bigdisp/scoreboard-hardware/case/case_uC_segment_control_lid.stl

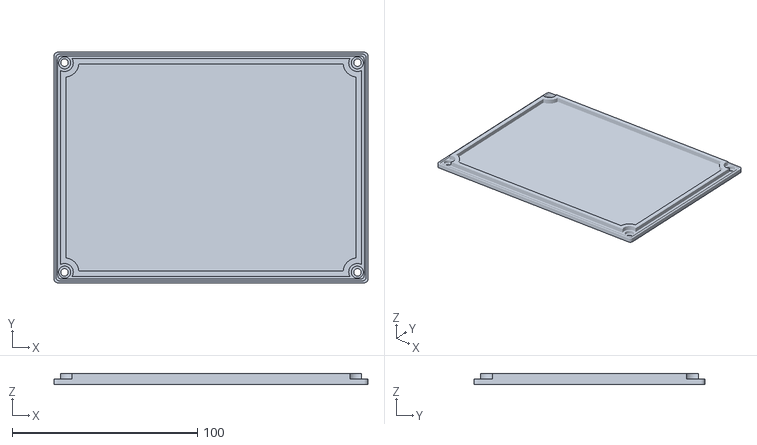
[picture p1: CAD file, 2016-05-19]
case/case_uC_segment_control_lid.stl
169.4 x 124.4 x 6.00
