bigdisp/scoreboard-hardware/case/case_uC_segment_control_box.stl

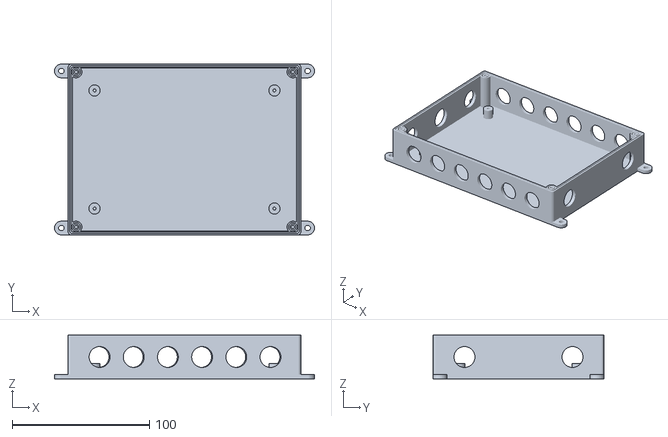
[picture p2: CAD file, 2016-05-19]
case/case_uC_segment_control_box.stl
189.4 x 124.4 x 31.7
