bigdisp/scoreboard-hardware/board_schematic/uC_segment_control.kicad_pcb

## KiCad design board_schematic/uC_segment_control.kicad_pcb (2016-05-19)

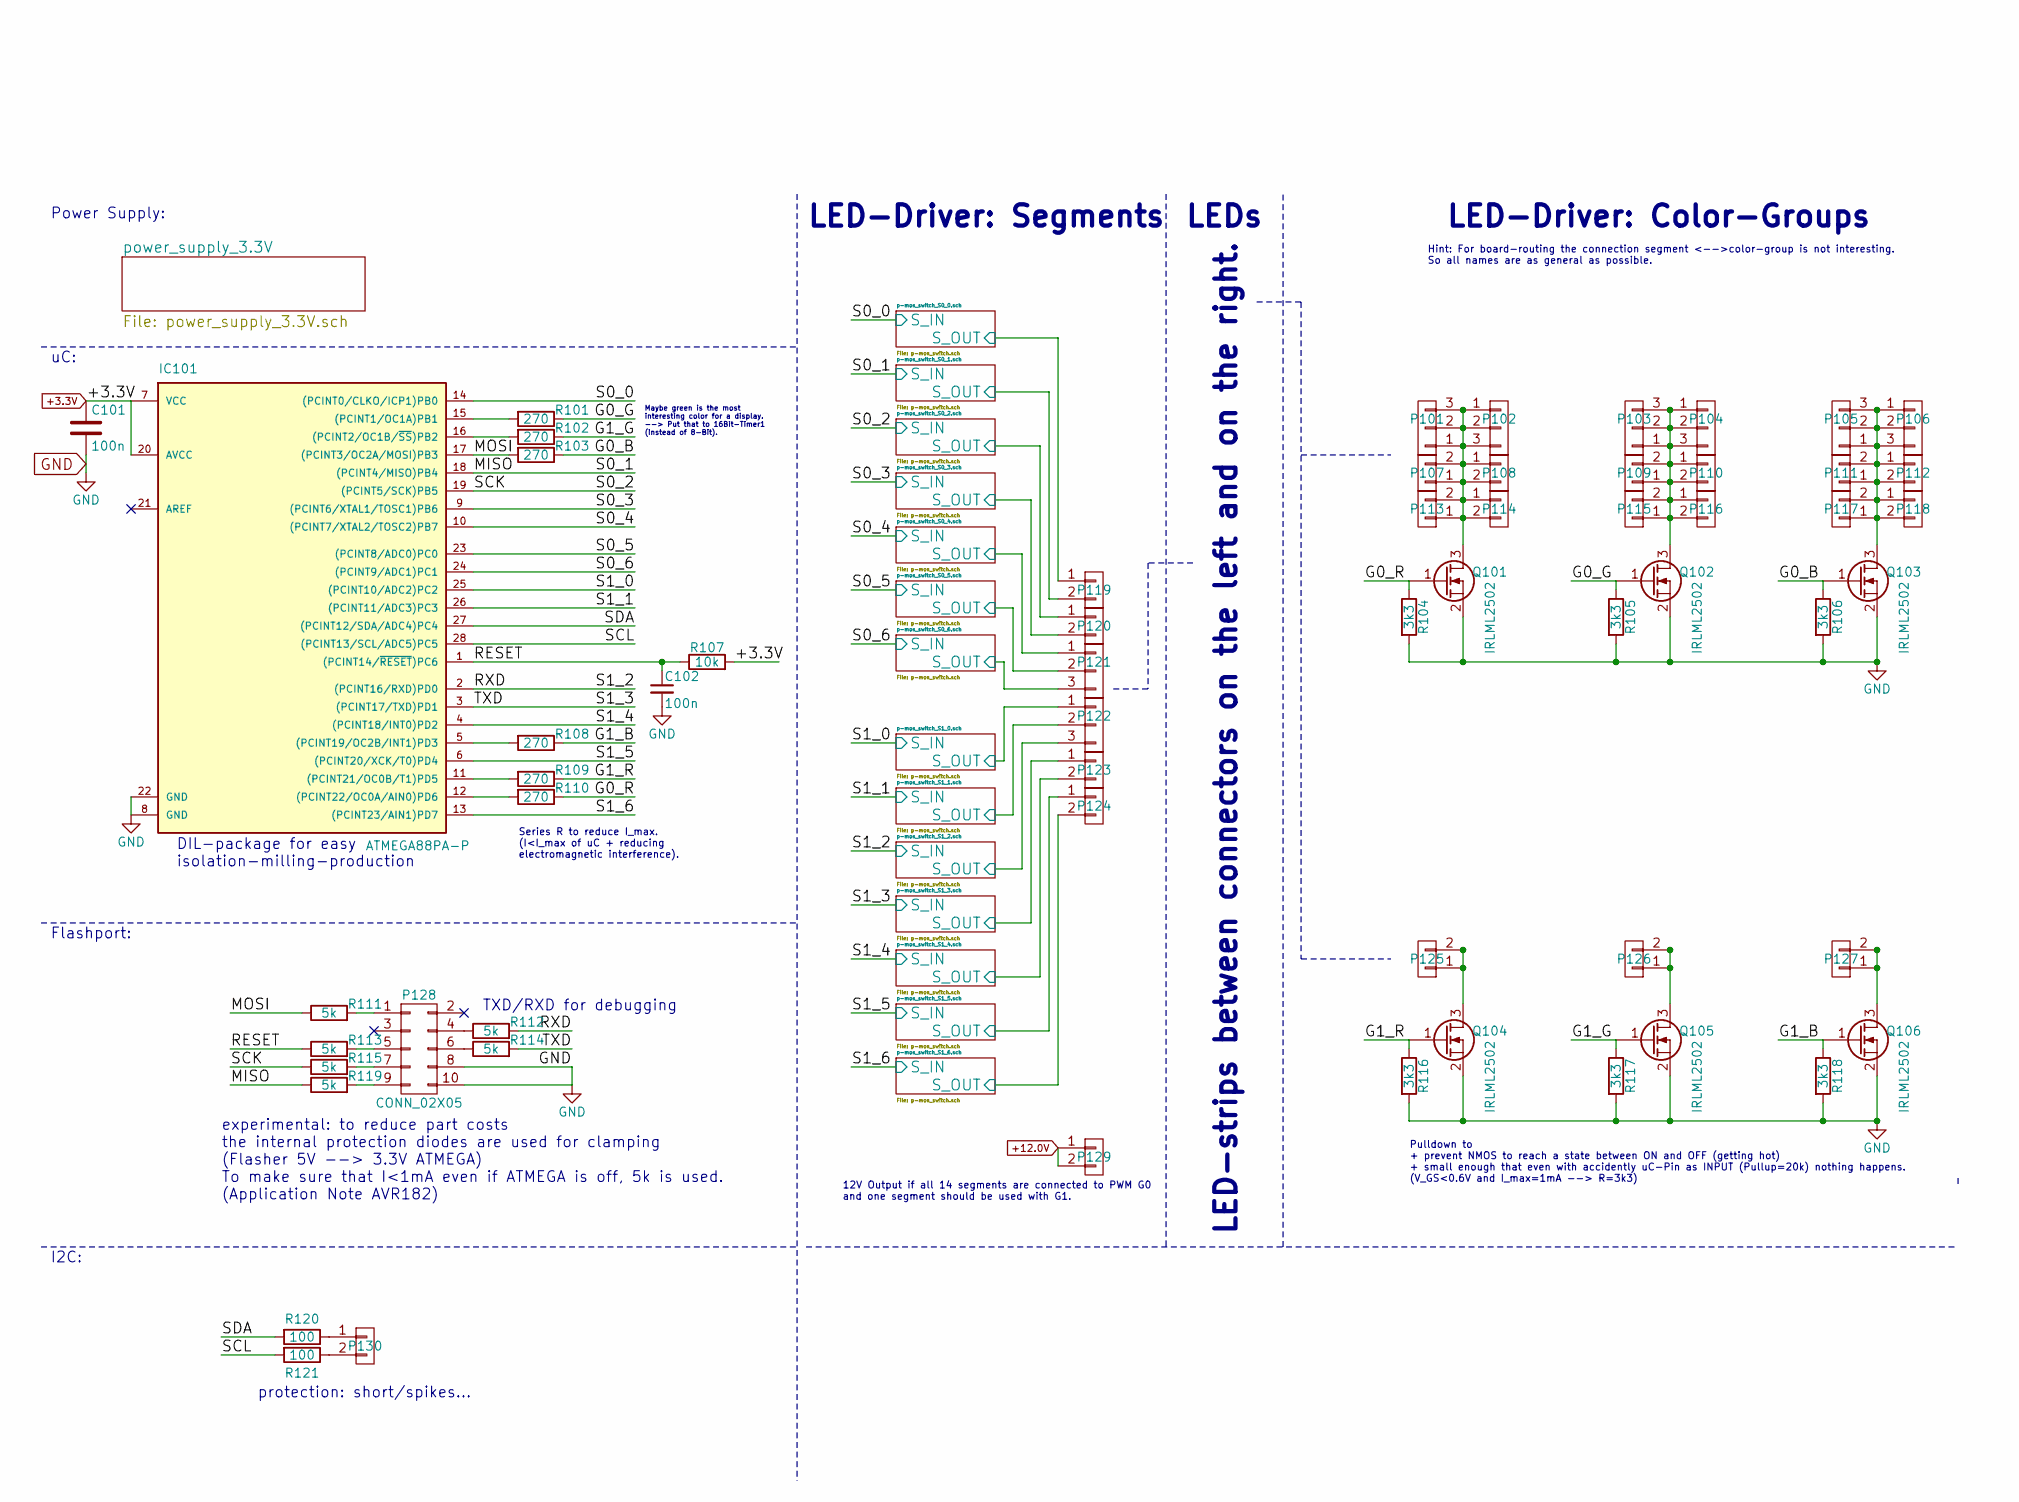
[picture p3: schematic uC_segment_control.sch]

Parts:
C101, C102: 100n; C_0805_HandSoldering
IC101: ATMEGA88PA-P; DIP-28_W7.62mm_LongPads
P101, P102, P103, P104, P105, P106, P121, P122: CONN_01X03; AK300-3
P107, P108, P109, P110, P111, P112, P113, P114, P115, P116, P117, P118, P119, P120, P123, P124, P125, P126, P127, P129, P130: CONN_01X02; AK300-2
P128: CONN_02X05; IDC_Header_Straight_10pins_0.6_clearance
Q101, Q102, Q103, Q104, Q105, Q106: IRLML2502; SOT-23_Handsoldering
R101, R102, R103, R108, R109, R110: 270; R_0805_HandSoldering
R104, R105, R106, R116, R117, R118: 3k3; R_0805_HandSoldering
R107: 10k; R_0805_HandSoldering
R111, R112, R113, R114, R115, R119: 5k; R_0805_HandSoldering
R120, R121: 100; R_0805_HandSoldering

Connections:
+3.3V: C101.1, IC101.7 (VCC), IC101.20 (AVCC), R107.2; also elsewhere on the board
+12.0V: P129.1, P129.2; also elsewhere on the board
/G0_B: Q103.1 (G), R103.1, R106.1
/G0_G: Q102.1 (G), R101.1, R105.1
/G0_R: Q101.1 (G), R104.1, R110.1
/G1_B: Q106.1 (G), R108.1, R118.1
/G1_G: Q105.1 (G), R102.1, R117.1
/G1_R: Q104.1 (G), R109.1, R116.1
/MOSI: IC101.17 ((PCINT3/OC2A/MOSI)PB3), R103.2, R111.1
/RESET: C102.1, IC101.1 ((PCINT14/~RESET~)PC6), R107.1, R113.1
/SCL: IC101.28 ((PCINT13/SCL/ADC5)PC5), R121.2
/SDA: IC101.27 ((PCINT12/SDA/ADC4)PC4), R120.2
/p-mos_switch_S0_0.sch/S_IN: IC101.14 ((PCINT0/CLKO/ICP1)PB0); also elsewhere on the board
/p-mos_switch_S0_0.sch/S_OUT: P119.1; also elsewhere on the board
/p-mos_switch_S0_1.sch/S_IN: IC101.18 ((PCINT4/MISO)PB4), R119.1; also elsewhere on the board
/p-mos_switch_S0_1.sch/S_OUT: P119.2; also elsewhere on the board
/p-mos_switch_S0_2.sch/S_IN: IC101.19 ((PCINT5/SCK)PB5), R115.1; also elsewhere on the board
/p-mos_switch_S0_2.sch/S_OUT: P120.1; also elsewhere on the board
/p-mos_switch_S0_3.sch/S_IN: IC101.9 ((PCINT6/XTAL1/TOSC1)PB6); also elsewhere on the board
/p-mos_switch_S0_3.sch/S_OUT: P120.2; also elsewhere on the board
/p-mos_switch_S0_4.sch/S_IN: IC101.10 ((PCINT7/XTAL2/TOSC2)PB7); also elsewhere on the board
/p-mos_switch_S0_4.sch/S_OUT: P121.1; also elsewhere on the board
/p-mos_switch_S0_5.sch/S_IN: IC101.23 ((PCINT8/ADC0)PC0); also elsewhere on the board
/p-mos_switch_S0_5.sch/S_OUT: P121.2; also elsewhere on the board
/p-mos_switch_S0_6.sch/S_IN: IC101.24 ((PCINT9/ADC1)PC1); also elsewhere on the board
/p-mos_switch_S0_6.sch/S_OUT: P121.3; also elsewhere on the board
/p-mos_switch_S1_0.sch/S_IN: IC101.25 ((PCINT10/ADC2)PC2); also elsewhere on the board
/p-mos_switch_S1_0.sch/S_OUT: P122.1; also elsewhere on the board
/p-mos_switch_S1_1.sch/S_IN: IC101.26 ((PCINT11/ADC3)PC3); also elsewhere on the board
/p-mos_switch_S1_1.sch/S_OUT: P122.2; also elsewhere on the board
/p-mos_switch_S1_2.sch/S_IN: IC101.2 ((PCINT16/RXD)PD0), R112.2; also elsewhere on the board
/p-mos_switch_S1_2.sch/S_OUT: P122.3; also elsewhere on the board
/p-mos_switch_S1_3.sch/S_IN: IC101.3 ((PCINT17/TXD)PD1), R114.2; also elsewhere on the board
/p-mos_switch_S1_3.sch/S_OUT: P123.1; also elsewhere on the board
/p-mos_switch_S1_4.sch/S_IN: IC101.4 ((PCINT18/INT0)PD2); also elsewhere on the board
/p-mos_switch_S1_4.sch/S_OUT: P123.2; also elsewhere on the board
/p-mos_switch_S1_5.sch/S_IN: IC101.6 ((PCINT20/XCK/T0)PD4); also elsewhere on the board
/p-mos_switch_S1_5.sch/S_OUT: P124.1; also elsewhere on the board
/p-mos_switch_S1_6.sch/S_IN: IC101.13 ((PCINT23/AIN1)PD7); also elsewhere on the board
/p-mos_switch_S1_6.sch/S_OUT: P124.2; also elsewhere on the board
GND: C101.2, C102.2, IC101.8 (GND), IC101.22 (GND), P128.8, P128.10, Q101.2 (S), Q102.2 (S), Q103.2 (S), Q104.2 (S), Q105.2 (S), Q106.2 (S), R104.2, R105.2, R106.2, R116.2, R117.2, R118.2; also elsewhere on the board
unnamed: IC101.5 ((PCINT19/OC2B/INT1)PD3), R108.2
unnamed: IC101.11 ((PCINT21/OC0B/T1)PD5), R109.2
unnamed: IC101.12 ((PCINT22/OC0A/AIN0)PD6), R110.2
unnamed: IC101.15 ((PCINT1/OC1A)PB1), R101.2
unnamed: IC101.16 ((PCINT2/OC1B/~SS~)PB2), R102.2
unnamed: P101.1, P101.2, P101.3, P102.1, P102.2, P102.3, P107.1, P107.2, P108.1, P108.2, P113.1, P113.2, P114.1, P114.2, Q101.3 (D)
unnamed: P103.1, P103.2, P103.3, P104.1, P104.2, P104.3, P109.1, P109.2, P110.1, P110.2, P115.1, P115.2, P116.1, P116.2, Q102.3 (D)
unnamed: P105.1, P105.2, P105.3, P106.1, P106.2, P106.3, P111.1, P111.2, P112.1, P112.2, P117.1, P117.2, P118.1, P118.2, Q103.3 (D)
unnamed: P125.1, P125.2, Q104.3 (D)
unnamed: P126.1, P126.2, Q105.3 (D)
unnamed: P127.1, P127.2, Q106.3 (D)
unnamed: P128.1, R111.2
unnamed: P128.4, R112.1
unnamed: P128.5, R113.2
unnamed: P128.6, R114.1
unnamed: P128.7, R115.2
unnamed: P128.9, R119.2
unnamed: P130.1, R120.1
unnamed: P130.2, R121.1

Notes on the sheet:
DIL-package for easy isolation-milling-production
experimental: to reduce part costs the internal protection diodes are used for clamping (Flasher 5V --> 3.3V ATMEGA) To make sure that I<1mA even if ATMEGA is off, 5k is used. (Application Note AVR182)
Power Supply:
uC:
Flashport:
LED-Driver: Segments
LED-Driver: Color-Groups
Hint: For board-routing the connection segment <-->color-group is not interesting. So all names are as general as possible.
LED-strips between connectors on the left and on the right.
LEDs
Series R to reduce I_max. (I<I_max of uC + reducing electromagnetic interference).
Maybe green is the most interesting color for a display. --> Put that to 16Bit-Timer1 (instead of 8-Bit).
Pulldown to + prevent NMOS to reach a state between ON and OFF (getting hot) + small enough that even with accidently uC-Pin as INPUT (Pullup=20k) nothing happens. (V_GS<0.6V and I_max=1mA --> R=3k3)
TXD/RXD for debugging
I2C:
protection: short/spikes...
12V Output if all 14 segments are connected to PWM G0 and one segment should be used with G1.

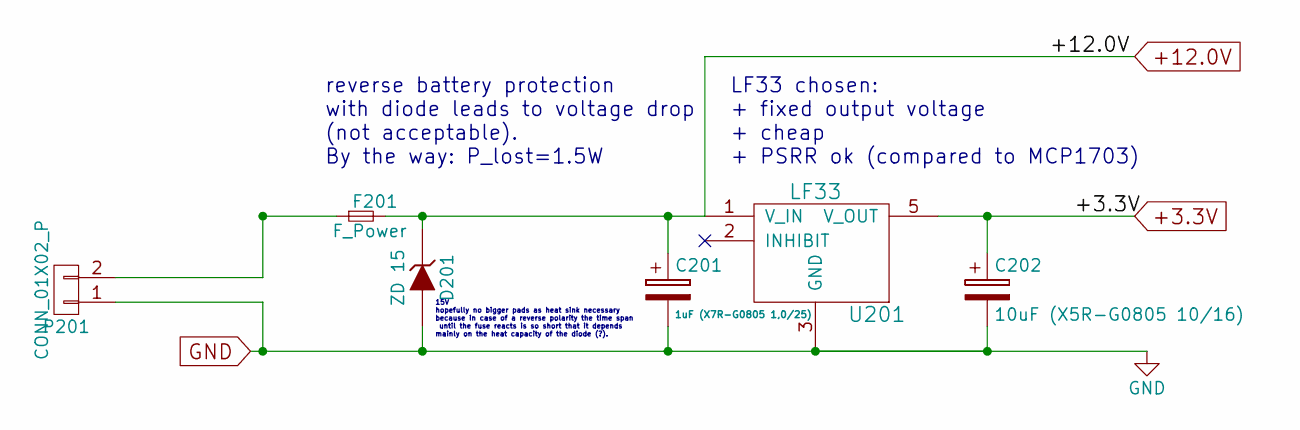
[picture p4: schematic power_supply_3.3V.sch, uC_segment_control]

Parts:
C201: 1uF (X7R-G0805 1,0/25); C_0805_HandSoldering
C202: 10uF (X5R-G0805 10/16); C_0805_HandSoldering
D201: ZD 15; Diode_DO-41_SOD81_Horizontal_RM10
F201: F_Power; Fuseholder5x20_horiz_SemiClosed_Casing10x25mm
P201: CONN_01X02_P; AK300-2
U201: LF33; D-PAK

Connections:
+3.3V: C202.1, U201.5 (V_OUT); also elsewhere on the board
+12.0V: C201.1, D201.1 (K), F201.2, U201.1 (V_IN); also elsewhere on the board
GND: C201.2, C202.2, D201.2 (A), P201.1, U201.3 (GND); also elsewhere on the board
unnamed: F201.1, P201.2

Notes on the sheet:
LF33 chosen: + fixed output voltage + cheap + PSRR ok (compared to MCP1703)
reverse battery protection with diode leads to voltage drop (not acceptable). By the way: P_lost=1.5W
15V hopefully no bigger pads as heat sink necessary because in case of a reverse polarity the time span until the fuse reacts is so short that it depends mainly on the heat capacity of the diode (?).

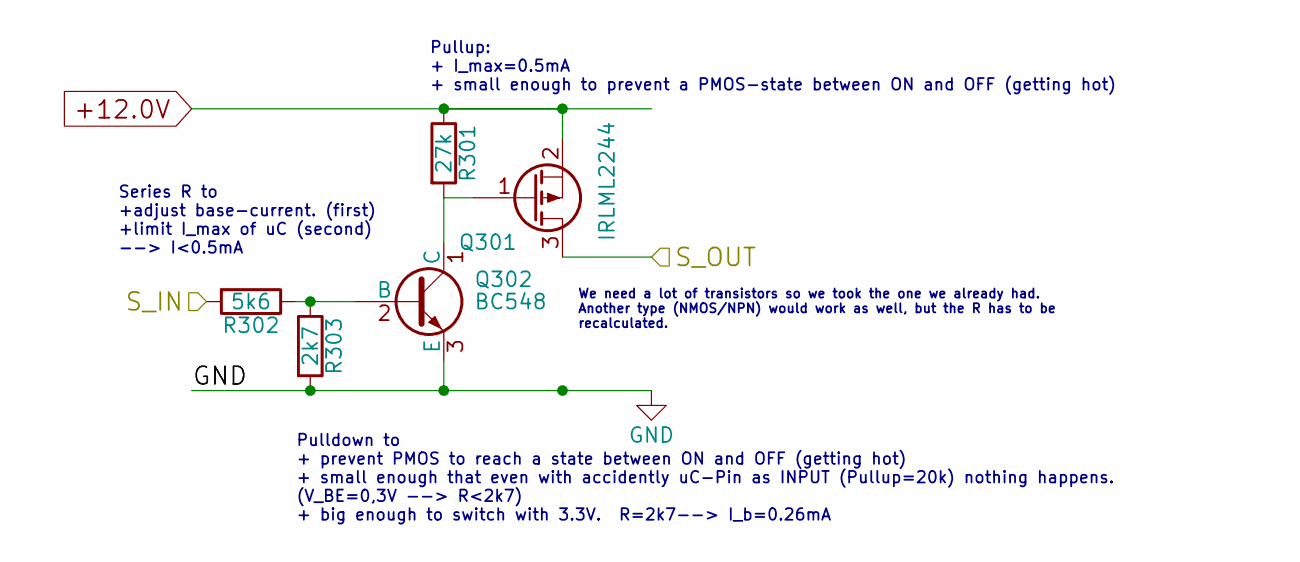
[picture p5: schematic p-mos_switch.sch, uC_segment_control]

Parts:
Q301: IRLML2244; SOT-23_Handsoldering
Q302: BC548; TO-92_Molded_0.6space_Oval
R301: 27k; R_0805_HandSoldering
R302: 5k6; R_0805_HandSoldering
R303: 2k7; R_0805_HandSoldering

Connections:
+12.0V: Q301.2 (S), R301.1; also elsewhere on the board
/p-mos_switch_S0_0.sch/S_IN: R302.2; also elsewhere on the board
/p-mos_switch_S0_0.sch/S_OUT: Q301.3 (D); also elsewhere on the board
GND: Q302.3 (E), R303.2; also elsewhere on the board
unnamed: Q301.1 (G), Q302.1 (C), R301.2
unnamed: Q302.2 (B), R302.1, R303.1

Parts of its further copies:
Q401, Q501, Q601, Q701, Q801, Q901, Q1001, Q1101, Q1201, Q1301, Q1401, Q1501, Q1601: IRLML2244; SOT-23_Handsoldering
Q402, Q502, Q602, Q702, Q802, Q902, Q1002, Q1102, Q1202, Q1302, Q1402, Q1502, Q1602: BC548; TO-92_Molded_0.6space_Oval
R401, R501, R601, R701, R801, R901, R1001, R1101, R1201, R1301, R1401, R1501, R1601: 27k; R_0805_HandSoldering
R402, R502, R602, R702, R802, R902, R1002, R1102, R1202, R1302, R1402, R1502, R1602: 5k6; R_0805_HandSoldering
R403, R503, R603, R703, R803, R903, R1003, R1103, R1203, R1303, R1403, R1503, R1603: 2k7; R_0805_HandSoldering

Connections of its further copies:
+12.0V: Q401.2 (S), Q501.2 (S), Q601.2 (S), Q701.2 (S), Q801.2 (S), Q901.2 (S), Q1001.2 (S), Q1101.2 (S), Q1201.2 (S), Q1301.2 (S), Q1401.2 (S), Q1501.2 (S), Q1601.2 (S), R401.1, R501.1, R601.1, R701.1, R801.1, R901.1, R1001.1, R1101.1, R1201.1, R1301.1, R1401.1, R1501.1, R1601.1; also elsewhere on the board
/p-mos_switch_S0_1.sch/S_IN: R402.2; also elsewhere on the board
/p-mos_switch_S0_1.sch/S_OUT: Q401.3 (D); also elsewhere on the board
/p-mos_switch_S0_2.sch/S_IN: R502.2; also elsewhere on the board
/p-mos_switch_S0_2.sch/S_OUT: Q501.3 (D); also elsewhere on the board
/p-mos_switch_S0_3.sch/S_IN: R602.2; also elsewhere on the board
/p-mos_switch_S0_3.sch/S_OUT: Q601.3 (D); also elsewhere on the board
/p-mos_switch_S0_4.sch/S_IN: R702.2; also elsewhere on the board
/p-mos_switch_S0_4.sch/S_OUT: Q701.3 (D); also elsewhere on the board
/p-mos_switch_S0_5.sch/S_IN: R802.2; also elsewhere on the board
/p-mos_switch_S0_5.sch/S_OUT: Q801.3 (D); also elsewhere on the board
/p-mos_switch_S0_6.sch/S_IN: R902.2; also elsewhere on the board
/p-mos_switch_S0_6.sch/S_OUT: Q901.3 (D); also elsewhere on the board
/p-mos_switch_S1_0.sch/S_IN: R1002.2; also elsewhere on the board
/p-mos_switch_S1_0.sch/S_OUT: Q1001.3 (D); also elsewhere on the board
/p-mos_switch_S1_1.sch/S_IN: R1102.2; also elsewhere on the board
/p-mos_switch_S1_1.sch/S_OUT: Q1101.3 (D); also elsewhere on the board
/p-mos_switch_S1_2.sch/S_IN: R1202.2; also elsewhere on the board
/p-mos_switch_S1_2.sch/S_OUT: Q1201.3 (D); also elsewhere on the board
/p-mos_switch_S1_3.sch/S_IN: R1302.2; also elsewhere on the board
/p-mos_switch_S1_3.sch/S_OUT: Q1301.3 (D); also elsewhere on the board
/p-mos_switch_S1_4.sch/S_IN: R1402.2; also elsewhere on the board
/p-mos_switch_S1_4.sch/S_OUT: Q1401.3 (D); also elsewhere on the board
/p-mos_switch_S1_5.sch/S_IN: R1502.2; also elsewhere on the board
/p-mos_switch_S1_5.sch/S_OUT: Q1501.3 (D); also elsewhere on the board
/p-mos_switch_S1_6.sch/S_IN: R1602.2; also elsewhere on the board
/p-mos_switch_S1_6.sch/S_OUT: Q1601.3 (D); also elsewhere on the board
GND: Q402.3 (E), Q502.3 (E), Q602.3 (E), Q702.3 (E), Q802.3 (E), Q902.3 (E), Q1002.3 (E), Q1102.3 (E), Q1202.3 (E), Q1302.3 (E), Q1402.3 (E), Q1502.3 (E), Q1602.3 (E), R403.2, R503.2, R603.2, R703.2, R803.2, R903.2, R1003.2, R1103.2, R1203.2, R1303.2, R1403.2, R1503.2, R1603.2; also elsewhere on the board
unnamed: Q401.1 (G), Q402.1 (C), R401.2
unnamed: Q402.2 (B), R402.1, R403.1
unnamed: Q501.1 (G), Q502.1 (C), R501.2
unnamed: Q502.2 (B), R502.1, R503.1
unnamed: Q601.1 (G), Q602.1 (C), R601.2
unnamed: Q602.2 (B), R602.1, R603.1
unnamed: Q701.1 (G), Q702.1 (C), R701.2
unnamed: Q702.2 (B), R702.1, R703.1
unnamed: Q801.1 (G), Q802.1 (C), R801.2
unnamed: Q802.2 (B), R802.1, R803.1
unnamed: Q901.1 (G), Q902.1 (C), R901.2
unnamed: Q902.2 (B), R902.1, R903.1
unnamed: Q1001.1 (G), Q1002.1 (C), R1001.2
unnamed: Q1002.2 (B), R1002.1, R1003.1
unnamed: Q1101.1 (G), Q1102.1 (C), R1101.2
unnamed: Q1102.2 (B), R1102.1, R1103.1
unnamed: Q1201.1 (G), Q1202.1 (C), R1201.2
unnamed: Q1202.2 (B), R1202.1, R1203.1
unnamed: Q1301.1 (G), Q1302.1 (C), R1301.2
unnamed: Q1302.2 (B), R1302.1, R1303.1
unnamed: Q1401.1 (G), Q1402.1 (C), R1401.2
unnamed: Q1402.2 (B), R1402.1, R1403.1
unnamed: Q1501.1 (G), Q1502.1 (C), R1501.2
unnamed: Q1502.2 (B), R1502.1, R1503.1
unnamed: Q1601.1 (G), Q1602.1 (C), R1601.2
unnamed: Q1602.2 (B), R1602.1, R1603.1

Notes on the sheet:
Pulldown to + prevent PMOS to reach a state between ON and OFF (getting hot) + small enough that even with accidently uC-Pin as INPUT (Pullup=20k) nothing happens. (V_BE=0,3V --> R<2k7) + big enough to switch with 3.3V. R=2k7--> I_b=0.26mA
We need a lot of transistors so we took the one we already had. Another type (NMOS/NPN) would work as well, but the R has to be recalculated.
Series R to +adjust base-current. (first) +limit I_max of uC (second) --> I<0.5mA
Pullup: + I_max=0.5mA + small enough to prevent a PMOS-state between ON and OFF (getting hot)

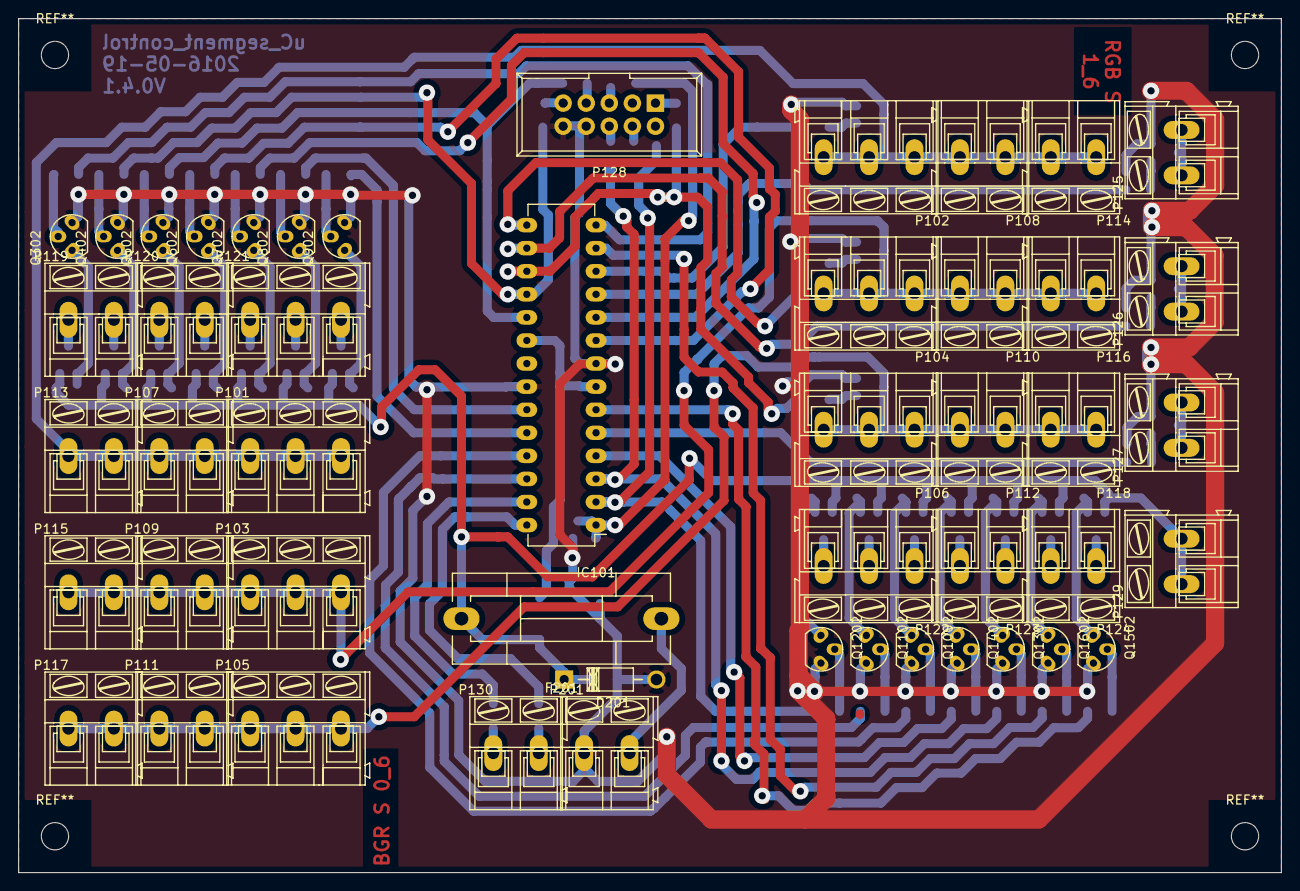
[picture p6: board uC_segment_control.kicad_pcb from above]

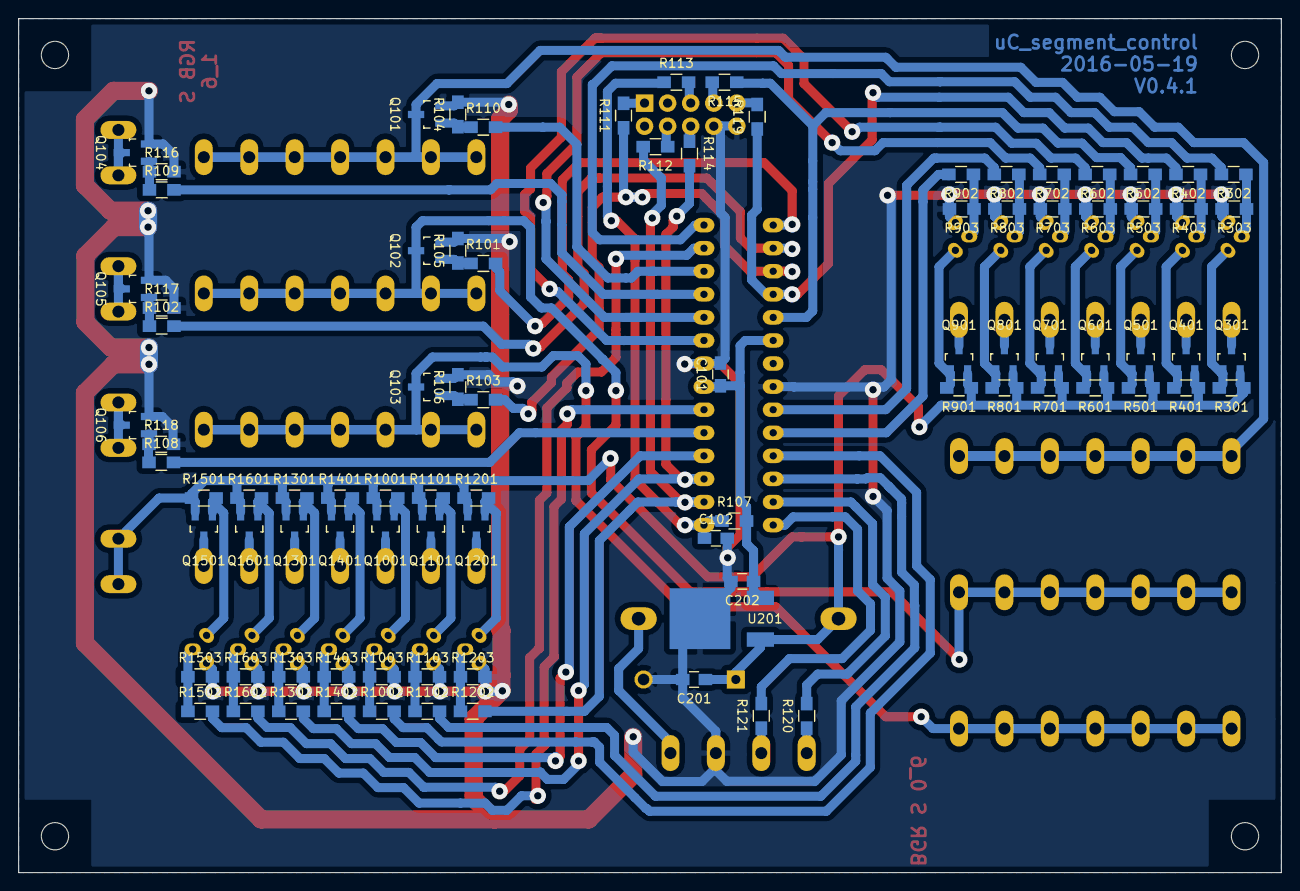
[picture p7: board uC_segment_control.kicad_pcb from below]

Board: 2 copper layers, 139.0 x 94.0 mm, 136 parts (88 on the bottom side), 89 nets.
