bigdisp/scoreboard-hardware/(threads)

Thread 10 (2016-04-30):

DCF77 receiver / temperature sensor for time display when not used for score

gn36, 2016-04-30:
It would be nice to be able to display the current time, if the scoreboard is not in use for the current score. This would be useful between two games, for example. Unless the raspi is connected to the internet, this will require some sort of dcf77 receiver to obtain the current time.

Could also be interleaved with current ambient temperature (which would require a temperature sensor).

Nice to have, not required.

Closed 2016-04-30.

Thread 11 (2016-04-30):

size of score-board

pluschris, 2016-04-30:
Typically plywood boards have sizes like 1250 x 2500 mm. Could you design the score-board inside that range?

gn36, 2016-04-30:
I will try to rearrange the elements. We also need a more detailed draft and determine the required length of the led stripes.

My last draft, which I think is already fairly condensed, used about 10% more area than that (~3.47m² compared to 3.13m²). Maybe I can reduce that a little bit.

To be determined:
- [ ] New draft
- [ ] Required length of led stripes for draft
- [ ] Required cuts of plywood board for draft

gn36, 2016-05-01:
Additionally, I will look for spare material we could use as a ground base at the field. There might be some material left over that we can use, especially after we had to close some holes after thieves broke in.

Thread 12 (2016-04-30):

extension board: DCF77-time, temperature, ambient light sensor.

pluschris, 2016-04-30:
It makes sense to combine all the additional features on one board and provide this information to the Raspberry Pi Controller.
(see #10 and #9)

gn36, 2016-05-11:
This could also contain a receiver for #19.

Thread 16 (2016-04-30):

Connection of 6 PWM-channels

pluschris, 2016-04-30:
@gn36: I found a uC with 6 PWM channels. When there are only two 7-segment-digits connected we can control the color of each digit separately. But if there are additionally two dots, I've no chance to control that color separately, too.

Do you prefer to control
 - the color of the digits and the color of the dots separately or
 - the color of the digits separately and a dot has the same color as on digit?

gn36, 2016-05-01:
Can't we solve the problem by doing the pwm in software? That is what I did so far at least. See [interrupt.c](https://github.com/bigdisp/scoreboard-atmega8-i2c/blob/master/src/interrupt.c#L124) and [pwm.c] (https://github.com/bigdisp/scoreboard-atmega8-i2c/blob/master/src/pwm.c#L8).

Then it would be primarily a question of a sufficient number of output pins and software timers, not whether they support pwm or not. I haven't tried this with multiple rgb outputs so far, though.

Getting back to your original question anyways: I think we need more than a single layout. Just for illustration, consider the old draft of the board:
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

- The display of the score ("Gast", "Heim") consists of two digits for each team and those two obviously belong together. So their color can be controlled together. Unless we recycle the point on these numbers for the point that marks which team is currently batting (which I wouldn't do, actually, because it logically belongs to the display of the inning and there should be enough channels on that one), I don't see any use for the point at all on these digits, so we can omit it entirely. Thus, we could use the 6 pwm channels for controlling the two digits separately here because we don't need the dot.

- The display of the inning needs 1.5 digits, but two dots. Originally, I was considering using the dots from the score ("Gast", "Heim") for this, but really, the 1.5 digits is only a single port (if we wire the point to the one in front), so we have the entire second port for the two dots. Here, I would like different colors for the dots and the number. If we can manage that, maybe even two different colors for the two dots, but that is not strictly necessary. If we simply put the two dots on the other port, we can use the same board layout as for the score digits, except that most of the port that is used for the first digit on "Heim" and "Gast" is not connected for "Inning". Wiring the point output on "Heim" and "Gast" to the same pwm ports, even though it is not used there doesn't really hurt either.

- The special digit for Balls, Strikes, and Outs is more difficult. Ideally, I would like a different setting for all three, because they all provide different information and it would make it easier to distinguish. Fortunately, we will only need a single port for controlling the segments, it is essentially a 7 segment display without dot. So we could use your 6 pwm ports for two of the three and realize the third pwm in software using the second port. Unfortunately, that means we cannot recycle the hardware for this and this would need special software (which I would integrate and switch using settings in the eeprom again).

So in conclusion, except for the special digit for "Balls", "Strikes", and "Outs", we should do separate colors on the two digits and consider the dot being part of the digit to be colored in the same color. The special digit needs a different layout capable of separating the elements of one digits into different colors.

pluschris, 2016-05-01:
Obviously different software versions and different boards aren't that nice concerning maintaining later on.
So I thought about it and it the following would cover all your requirements:
 * Full control to the main controller=Raspberry (every strip can be addressed from the main controller, no mapping at the uC. That makes new figures and effects pretty easy: You don't need to open the uC-case...)
* 4uC-boards (each has 2x3 PWM-channels: 1x3 PWMs for two digits and 1x3 PWMs for two dots). That makes sure that brightness does not depend on other interrupt activities), for example:
  * "Gast"-number and inning dot 1
  * "Heim"-number and inning dot 2
  * Inning-number and outs
  * Balls and strikes

You could control the color of each block individually and we need just one board and one software.

gn36, 2016-05-01:
Ok that works.

Thread 17 (2016-04-30):

scoreboard: surface treatment: LED recess

pluschris, 2016-04-30:
@gn36: Is it still up to date that we'll use a router for the LED recesses? Could you clarify if you'll get one? Otherwise I could ask a friend of mine...

gn36, 2016-05-01:
Yes, I can get one. We have to make sure that the recesses are not too deep, otherwise we might limit the viewing angle of the board. Also we have to make sure that we angle the bottom of the recesses so excess water can leave the recess.

Thread 9 (2016-04-30):

ambient light sensor for brightness control

pluschris, 2016-04-30:

gn36, 2016-04-30:
This could potentially be realized as a secondary master on the i2c bus, sending broadcasts to all digits.

But probably it is best to have all control logic in one place and use the raspi for the control and either realize this directly with the raspi in some way (e.g. an astable setup with a NE555 counter with an ldr and interval counting on one of the gpio pins of the raspi or something similar)

Also, I would see this as nice to have, not as a requirement, really. The board will work fine even if it is not dimmed when it is dark.

pluschris, 2016-04-30:
That's why I didn't set the "First Release"-Milestone. If the score-board is running, we can add an extension board.

Closed 2016-04-30.

Thread 18 (2016-05-01):

Power supply housing

gn36, 2016-05-01:
We need a housing for the power supply. The power supply is not intended for outdoor use, so we need waterproof housing for it.

The dimensions are approximately 180 x 105 x 40 mm. It provides 21 A at 12 V from 100-240V, 4A.

Thread 19 (2016-05-11):

Optional: Hardware Remote Controller

gn36, 2016-05-11:
It might be nice to have a dedicated remote control that could be used instead of the web interface. This should be considered optional for now, though.

- ISM 433 MHz TX/RX (-> Receiver on Raspi side necessary)
- 7 Buttons for Scoreboard Display (Balls, Strikes, Outs, +Score, -Score, +Inning, -Inning)
- Additional Buttons to switch Modes or control settings (Clock, Temperature, Brightness, Colors, ...)
- Battery powered
