bigdisp/scoreboard-hardware/(commit log)

2016-05-05 V0.2.1: First schematic for BOM
    [p-mos_switch.sch, power_supply_3.3V.sch, uC_segment_control.kicad_pcb, uC_segment_control.sch, uC_segment_control_BOM_V0.2.1.csv]
2016-05-12 V0.3.1: First layout
    [p-mos_switch.sch, power_supply_3.3V.sch, uC_segment_control.kicad_pcb, uC_segment_control.sch]
2016-05-19 V0.4.1 bigger pads footprint flashport for better milling. Case added.
    [case_uC_segment_control.scad, case_uC_segment_control_box.stl, case_uC_segment_control_lid.stl, p-mos_switch.sch, uC_segment_control.kicad_pcb, uC_segment_control.sch]
